CircuitCo/BeagleBone-DVI-D-RevA2/README

The DVI-D cape provides a DVI-D interface for BeagleBone boards. This board features a standard HDMI connector, which can be connected to a DVI-D monitor using a HDMI-to-DVI-D cable. When purchasing the BeagleBone DVI-D cape, customers have an option of adding the audio features to the cape. The BeagleBone DVI-D cape with audio features will include Audio In and Audio Out ports.
