CircuitCo/BeagleBone-DVI-D-RevA2/BeagleBone-DVI-D-RevA2-bom.xls

 |  | BeagleBone DVI-D Cape Rev A2 | 2012-06-27
 |  | Assy: -000
ITM | QTY | REF DESIGNATIORS | PART | DESCRIPTION | MAN | PART # | COMMENT
1 | 17 | C7,C8,C9,C10,C11,C12,C13,C14,C15,C16,C18,C19,C20,C21,C22,C23,C79 | 0.1uF | Capacitor 0.1uF 16V 10% 0402 X7R | Kemet | C0402C104K4RACT
2 | 5 | C1,C2,C3,C4,C17, | 10uF,0805 | CAP CER 10UF 10V Y5V 0805 | TDK | C2012Y5V1A106Z
3 | 2 | D5,D6 | 598-8170-107F | LED Green SMD 20mA 2V 0805 | Dialight | 598-8170-107F
4 | 4 | FB1,FB2,FB3,FB8 | IND,MMZ1608R301A | FERRITE CHIP 300 OHM 500MA 0603 | TDK | MMZ1608R301A
5 | 1 | SW1 | 2 POS Dip Switch | SWITCH TAPE SEAL 2 POS SMD | CTS | 219-2MST
6 | 2 | P1,P2 | 2x23 HEADER FEMALE | .100 CL Dual Row- Straight Socket Strip- using .025" Sq. Pins | MLE | SSHQ-123-D-08-G-LF
 |  |  | 2x23 HEADER FEMALE | .100 CL Dual Row- Straight Socket Strip- using .025" Sq. Pins | MLE | SSHQ-123-D-08-F-LF
7 | 1 | P3 | 2x5 HEADER FEMALE | .100 CL Dual Row- Straight Socket Strip- using .025" Sq. Pins | MLE | SSHQ-105-D-08-G-LF
 |  |  | 2x5 HEADER FEMALE | .100 CL Dual Row- Straight Socket Strip- using .025" Sq. Pins | MLE | SSHQ-105-D-08-F-LF
8 | 1 | P4 | CONN_HDMI | CONN RCPT HDMI TYPE A R/A SMD | FCI | 10029449-001RLF
9 | 1 | Q1 | DMC56404 | TRANS NPN/NPN W/RES 50V SMINI6 | Panasonic | DMC564040R
10 | 1 | RT1 | PTC_RXEF010 | POLYSWITCH PTC RESET 0.1A | Polyswitch | RXEF010
11 | 20 | R16,R18,R20,R22,R24,R26,R28,R31,R33,R35,R36,R38,R40,R42,R44,R45,R58,R60,R62,R64, | 33402 | RES 33.0 OHM 1/16W 1% 0402 SMD | Yaego | RC0402FR-0733RL
12 | 20 | R37,R39,R41,R43,R52,R54,R59,R63,R65,R66,R69,R70,R74,R75,R76,R77,R78,R79,R80,R81 | 10402 | RES 10.0 OHM 1/16W 1% 0402 SMD | Yaego | RC0402FR-0710RL
13 | 4 | R86,R90,R94,R95,R123 | 10K | Resistor 10Kohm 1/16W 5% 0402 | Rohm | MCR01MZPJ103
14 | 1 | R87 | 510 | RES 510 OHM 1/16W 1% 0402 SMD | Yaego | RC0402FR-07510RL
15 | 2 | R88,R92 | 1.1K | RES 1.10K OHM 1/16W 1% 0402 SMD | Yageo | RC0402FR-071K1L
16 | 5 | R89,R93,R116,R117,R118 | 4.75K | RES 4.75K OHM 1/16W 1% 0402 SMD | Stackpole Electronics | RMCF0402FT4K75
17 | 1 | R111 | .1,0805 | RES .10 OHM 1/8W 5% 0805 | CTS | 73L3R10J
18 | 2 | R119,R120 | 470,5% | RES 470 OHM 1/10W 5% 0402 SMD | Panasonic | ERJ-2GEJ471X
19 | 2 | R121,R122 | 100K,1% | Resistor 100Kohm 1/16W 1% 0402 | Yageo | CRCW0402100KJNED
20 | 2 | R114,R115 | 5.6K | RES 5.6K OHM 1/16W 5% 0402 SMD | Yaego | RC0402JR-075K6L
21 | 1 | U1 | 74AVC32t245 | IC BUS TRANSCVR 32BIT 96BGA | TI | SN74AVC32T245ZKER
22 | 1 | U2 | TFP410 | IC TRANSMITTER DIGITAL 64-HTQFP | TI | TFP410PAP
23 | 1 | U3 | TXS0102DCU | IC VOLT-LEVEL TRANSLATOR 8-US8 | TI | TXS0102DCUR
24 | 1 | U8 | CAT24C256W | IC EEPROM 256KBIT 400KHZ 8SOIC | ON | CAT24C256WI-G
 | DNI | C50,C51,C52,C54,C57,C60,C63,C78,C80
 |  | C55,C56,C58,C59,C62,C46,C47,C48,C49,C53,C61
 |  | C5,C6,C67,C68,C69,C70,C71,C72,C73,C74,C75,C76,C77,C81
 |  | D1,D2,D3,D4,FB6,FB7,P6,P7,R108,R109,R110,R91
 |  | R96,R97,R98,R107,R112,R113,U6,U7,U9,Y1,R1
 |  | R130,R131,R132,R133
