CircuitCo/BeagleBone-DVI-D-RevA2/(list of files, drawings)

Other design files:
BeagleBone-DVI-D-RevA2-schematic.dsn
